ZHANG-EH/High-Speed-Photography-Assistant/README.md

# High-Speed-Photography-Assistant
VG100 Final Project at Shanghai Jiao Tong University (SJTU)
